Klapautsiy/The-display-for-Elektronika-MK-85/MK85_PCB_C9.png

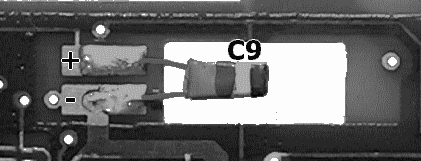
MK85_PCB_C9.png
