Klapautsiy/The-display-for-Elektronika-MK-85/MK85_PCB_SHIFT_SYNC_AD.png

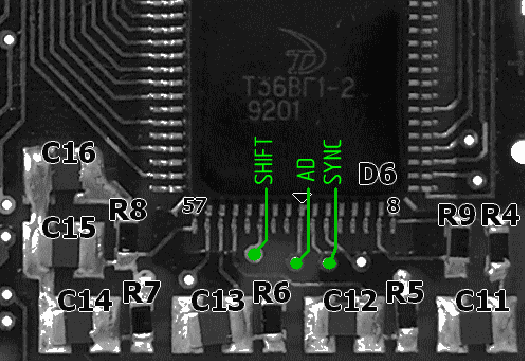
MK85_PCB_SHIFT_SYNC_AD.png
