Klapautsiy/The-display-for-Elektronika-MK-85/MK-85_scheme_CD4094BE_ATmega8_OLED1602.png

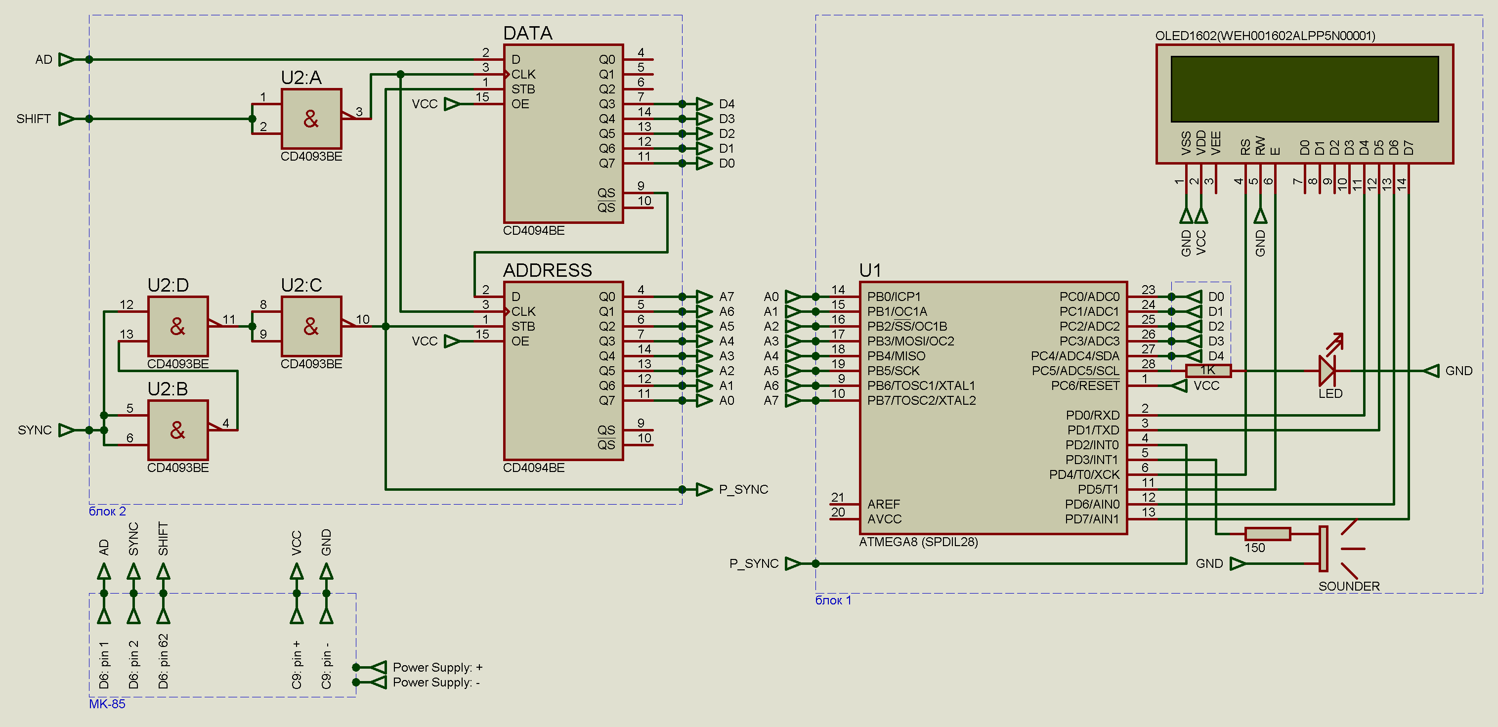
MK-85_scheme_CD4094BE_ATmega8_OLED1602.png
