Klapautsiy/The-display-for-Elektronika-MK-85/MK-85_scheme_CD4094BE_serial_8-5-bit.png

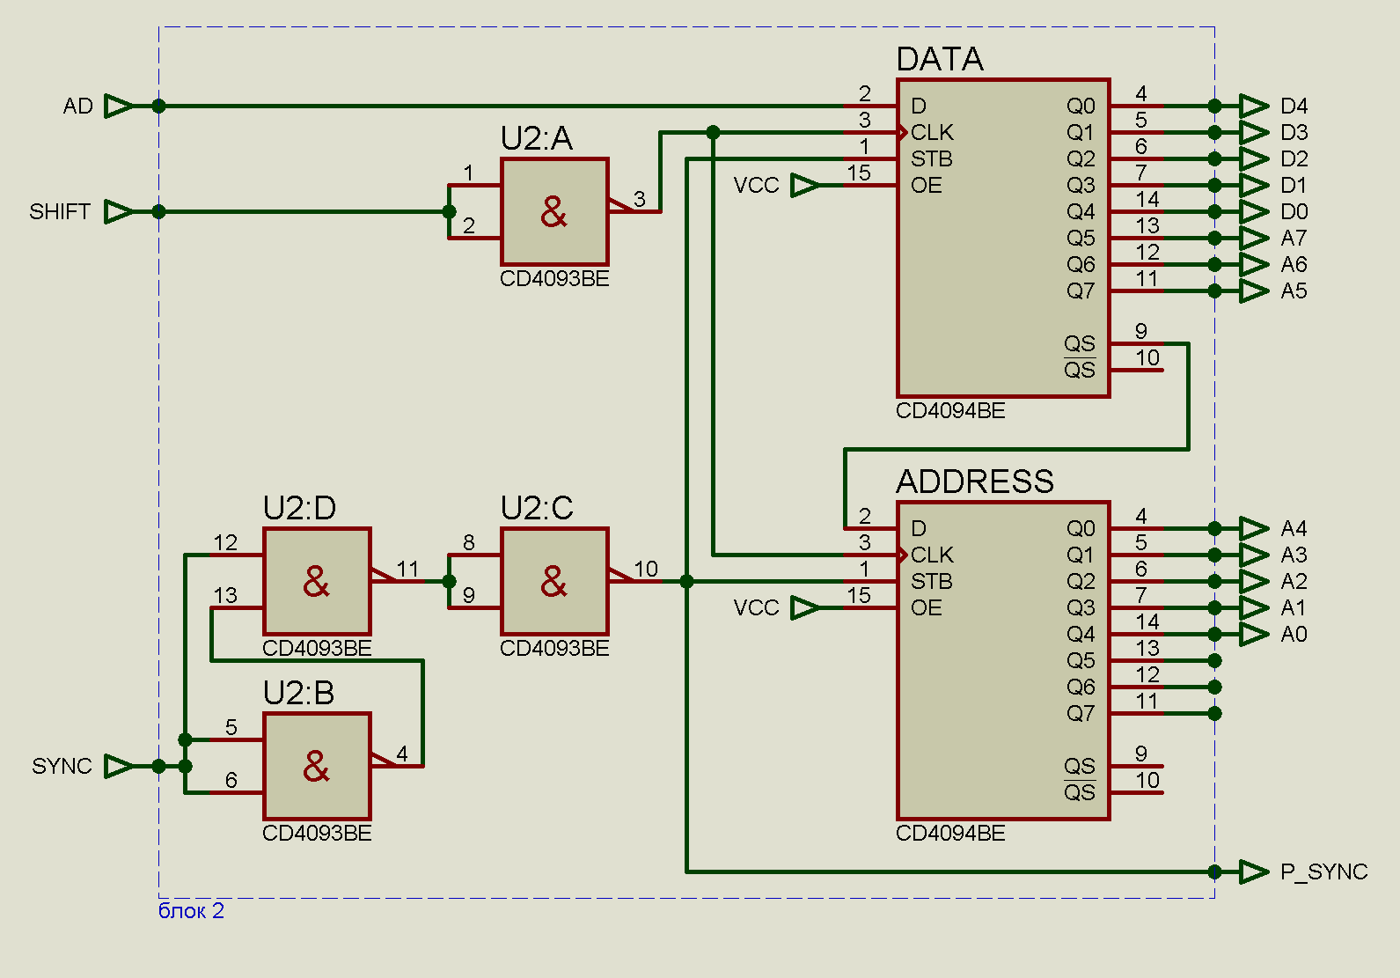
MK-85_scheme_CD4094BE_serial_8-5-bit.png
