Klapautsiy/The-display-for-Elektronika-MK-85/MK-85_scheme_Power_Supply.png

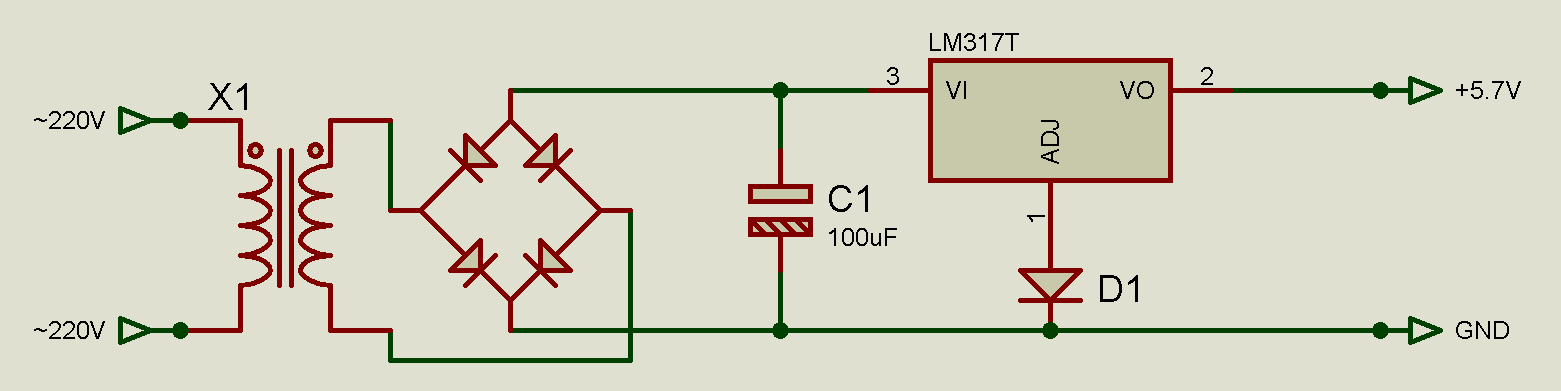
MK-85_scheme_Power_Supply.png
