Klapautsiy/The-display-for-Elektronika-MK-85/(threads)

Thread 1 (2020-10-20):

Проблема с отображением на дисплее

makstt232, 2020-10-20:
Добрый день.
Достался мне МК-85 с убитым дисплеем.
Собрал вашу схему, но есть одна проблема.
Опытным путем было установлена, что схема относительно нормально работает при установке конденсатора емкостью около 100 пФ  между выходом 3 CD4093BE и землей. При этом все равно не совсем некорректно  отображаются пиксели.
Возможно вы сталкивались с такой проблемой при разработке и у вас есть рекомендации.
Заранее спасибо за ответ.

makstt232, 2020-10-30:
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

Проблема полностью решилась установкой керамических конденсаторов 220 пФ между выводом 3 микросхемы CD4093BE и общим проводником  и между выводом 4 микросхемы CD4093BE и общим проводником

makstt232, 2020-10-30:
Проблема полностью решилась установкой керамических конденсаторов 220 пФ между выводом 3 микросхемы CD4093BE и общим проводником  и между выводом 4 микросхемы CD4093BE и общим проводником

Closed 2020-10-30.

Thread 2 (2023-10-15):

Вопрос по CD4093

Merzavets, 2023-10-15:
Здравствуйте! У меня есть МК-85 и МК-85М. Оба работают, но на "эмке" потёк экранчик (просто от старости). Соответственно, 85 будет донором экранчика для 85М. При этом обидно терять исправное устройство. И вот я нашёл ваш великолепный проект, просто чудо какое-то! Хочу осмелиться его повторить.
Сразу же возник вопрос по схеме: а для чего входы Shift и Sync вы отправляете через CD4093? И почему Sync проходит целый двухэтапный каскад триггеров?

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

Извините, если вопрос "нубский", но я не очень соображаю в "цифре".

Заранее спасибо за ответ. Наверняка по мере его реализации в железе у меня будут возникать новые вопросы, если вас не сильно напряжёт, то буду спрашивать :-)
